Ch3ru09/keyboardA/3d models/HRO  TYPE-C-31-M-12.step

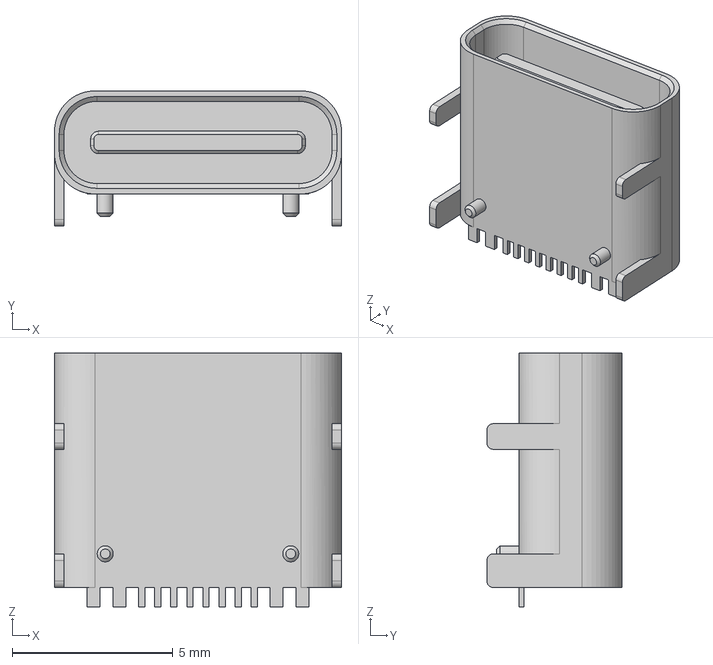
[picture p1: CAD file, 2026-08-06]
3d models/HRO TYPE-C-31-M-12.step
8.94 x 4.21 x 7.90 mm
