Ch3ru09/keyboardA/left/left_base.stl

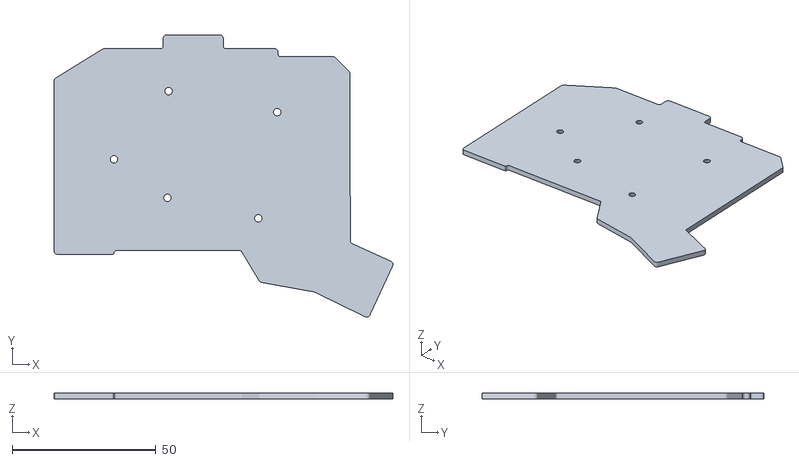
[picture p2: CAD file, 2026-08-14]
left/left_base.stl
118.0 x 98.3 x 2.00
