Ch3ru09/keyboardA/right/right_base.stl

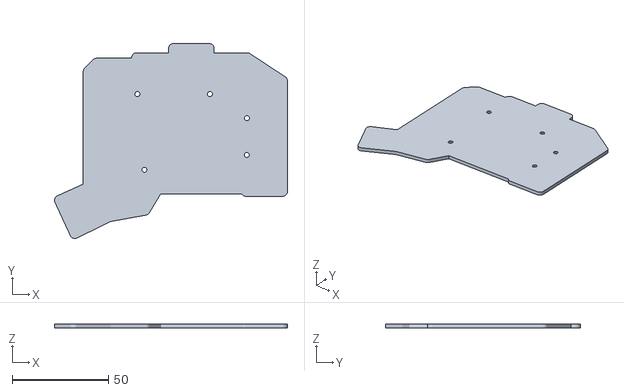
[picture p3: CAD file, 2026-08-14]
right/right_base.stl
120.8 x 101.1 x 2.00
