Ch3ru09/keyboardA/3d models/SW_Kailh_Choc_V1.stp

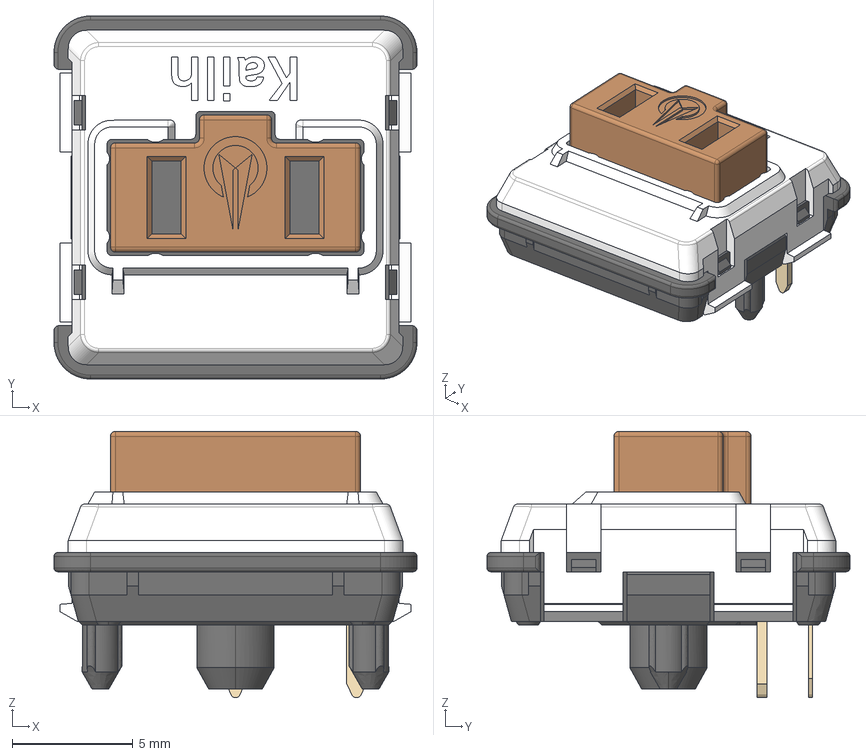
[picture p4: CAD file, 2026-08-06]
3d models/SW_Kailh_Choc_V1.stp
15.0 x 15.0 x 11.0 mm
