Ch3ru09/keyboardA/left/left_cover.stl

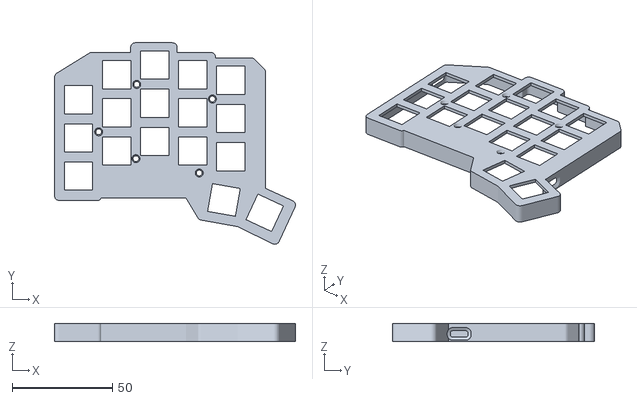
[picture p5: CAD file, 2026-08-14]
left/left_cover.stl
120.4 x 100.7 x 9.00
