Ch3ru09/keyboardA/right/right.step

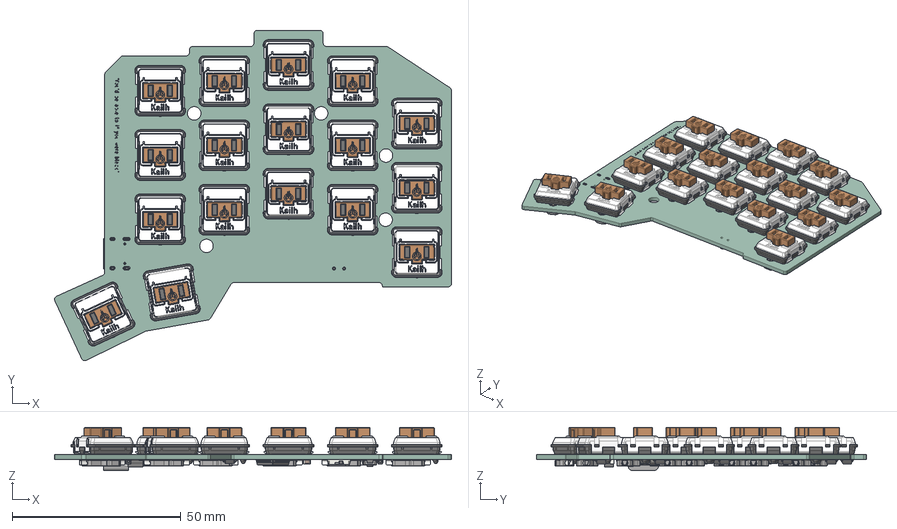
[picture p6: CAD file, 2026-08-14]
right/right.step
117.6 x 97.9 x 12.8 mm
SW_Kailh_Choc_V1_cp x 17
SW_Hotswap_Kailh_Choc_v1 x 17
Fusion_sp
D_SOD-123 x 17
MSOP-10_3x3mm_P0.5mm
LQFP-48_7x7mm_P0.5mm
C_0805_2012Metric x 7
HRO TYPE-C-31-M-12 v4
R_0805_2012Metric x 3
SOT-23-6
D_SMA
Fuse_1206_3216Metric
SOT-23-3
SW_SPST_TS-1088-xR020
right_pad
right_silkscreen x 2
right_PCB
