Ch3ru09/keyboardA/3d models/SW_Hotswap_Kailh_Choc_V1.stp

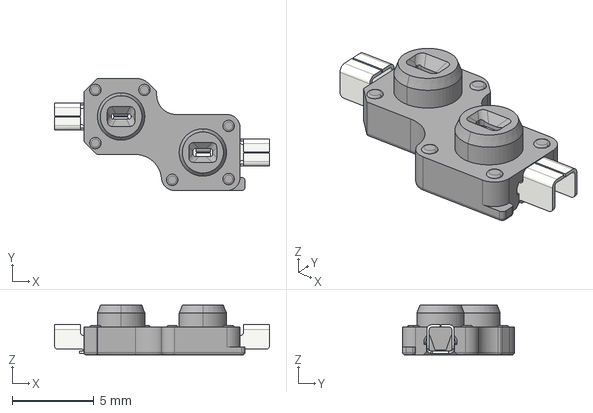
[picture p7: CAD file, 2026-08-06]
3d models/SW_Hotswap_Kailh_Choc_V1.stp
13.2 x 6.85 x 3.05 mm
