Ch3ru09/keyboardA/right/right_cut.step

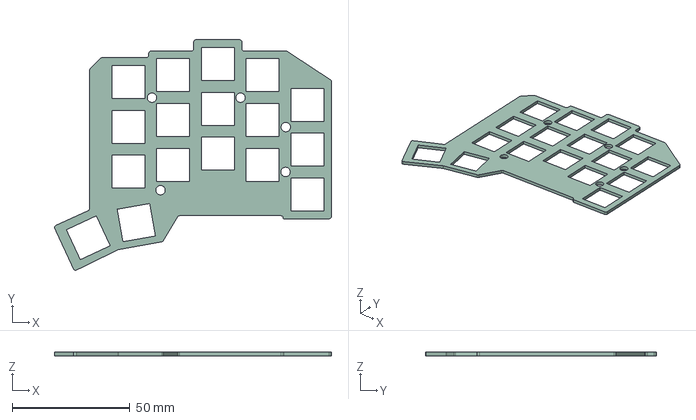
[picture p8: CAD file, 2026-08-14]
right/right_cut.step
117.6 x 97.9 x 1.51 mm
