Ch3ru09/keyboardA/left/left.step

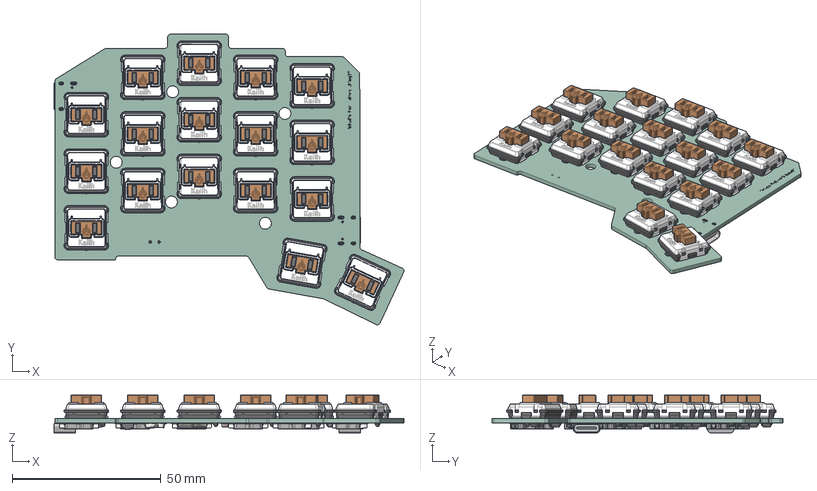
[picture p9: CAD file, 2026-08-06]
left/left.step
117.8 x 97.9 x 12.8 mm
D_SOD-123 x 17
SW_Kailh_Choc_V1_cp x 17
SW_Hotswap_Kailh_Choc_v1 x 17
SOT-23-6 x 2
C_0805_2012Metric x 7
HRO TYPE-C-31-M-12 v4 x 2
Fusion_sp
LQFP-48_7x7mm_P0.5mm
R_0805_2012Metric x 3
SOT-23-3
SW_SPST_TS-1088-xR020
Fuse_1206_3216Metric
left_pad
left_silkscreen x 2
left_PCB
