Ch3ru09/keyboardA/(list of files, cad)

Other CAD files:
right/right_cover.stl
3d models/USB_C_Receptacle_HRO_TYPE-C-31-M-12.step
left/left_cover_print_test.stl
left/left_base_print_test.stl
left/left_cover.f3z
right/right_cover.f3z
