Ch3ru09/keyboardA/right/right.kicad_pcb

## KiCad design right/right.kicad_pcb (2026-08-14)

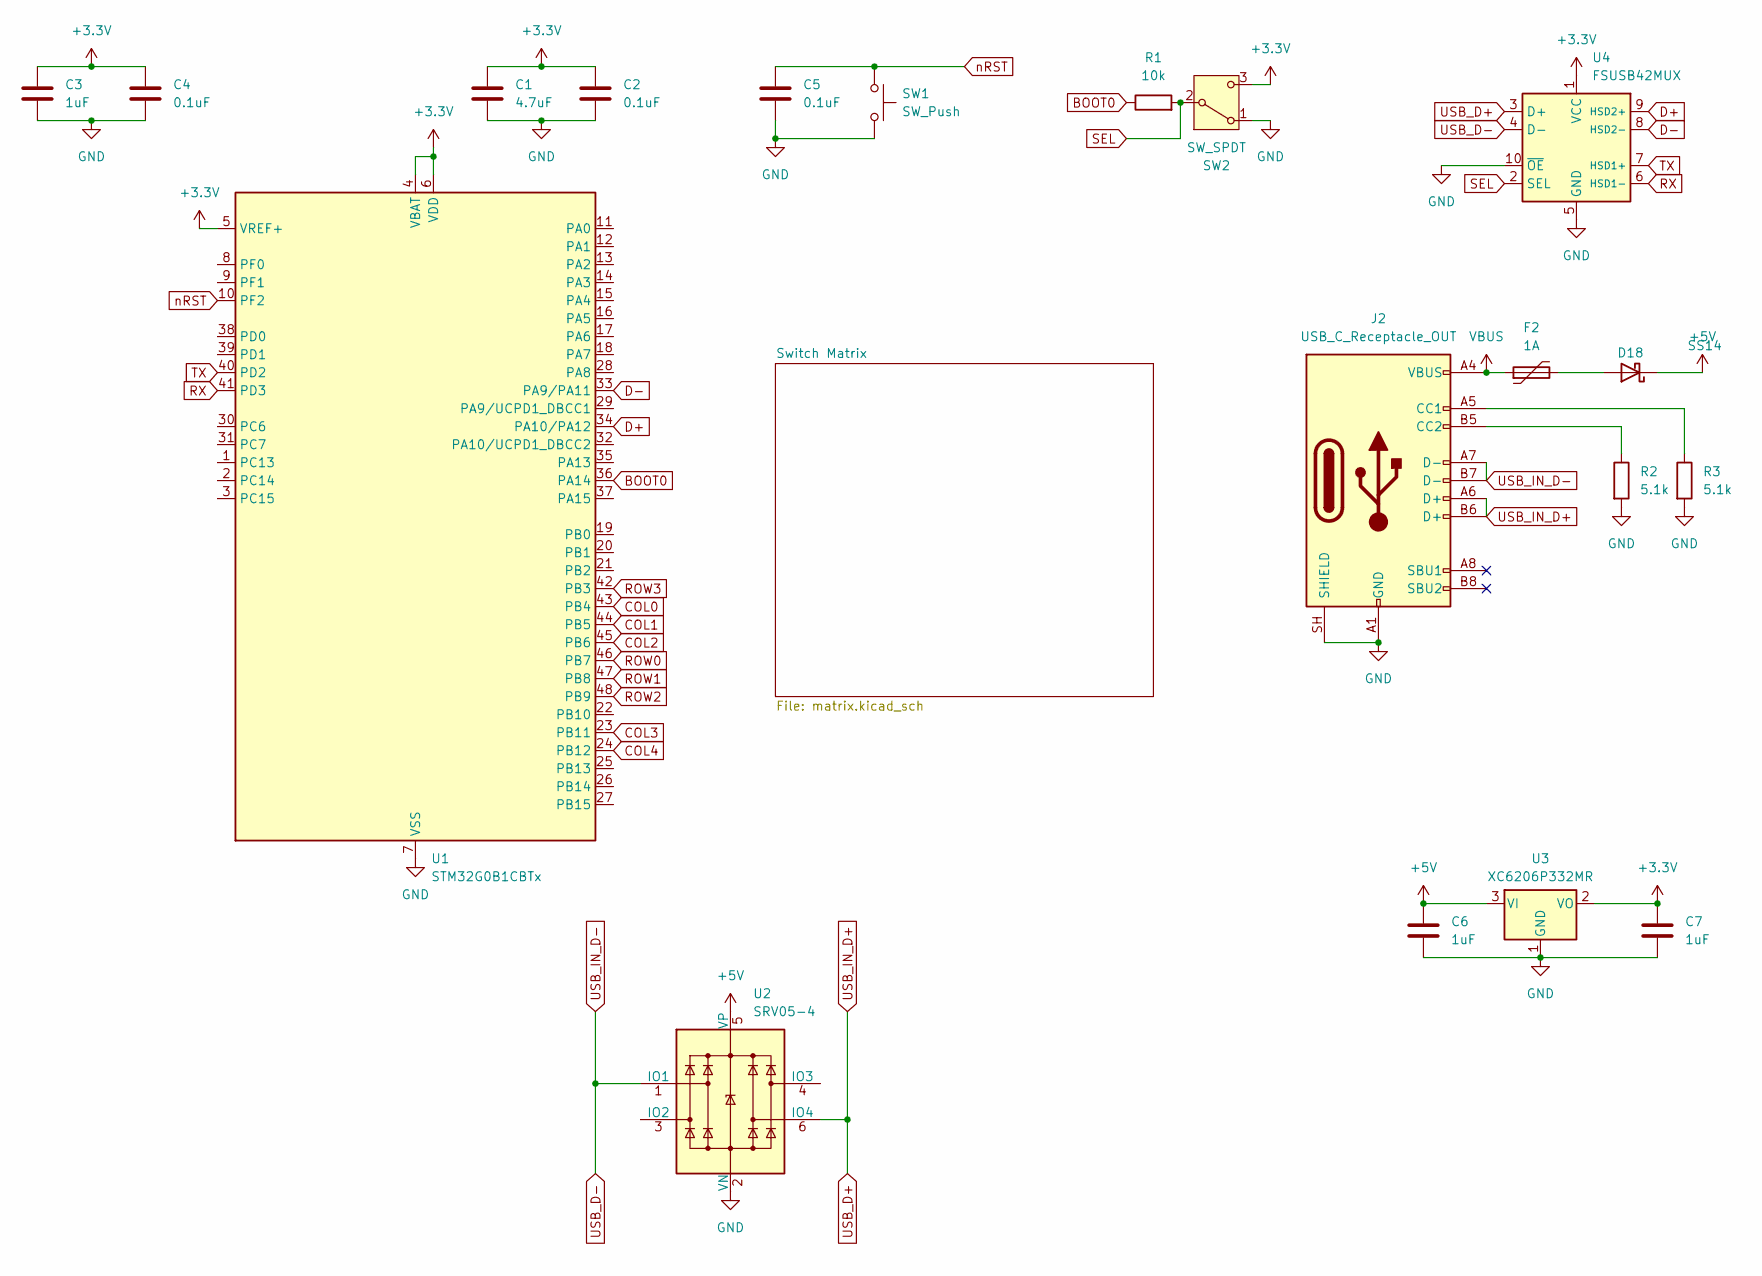
[picture p10: schematic right.kicad_sch]

Parts:
C1: 4.7uF; C_0805_2012Metric_Pad1.18x1.45mm_HandSolder
C2, C4, C5: 0.1uF; C_0805_2012Metric_Pad1.18x1.45mm_HandSolder
C3, C6, C7: 1uF; C_0805_2012Metric_Pad1.18x1.45mm_HandSolder
D18: SS14; D_SMA_Handsoldering
F2: 1A; Fuse_1206_3216Metric
J2: USB_C_Receptacle_OUT; USB_C_Receptacle_HRO_TYPE-C-31-M-12
R1: 10k; R_0805_2012Metric_Pad1.20x1.40mm_HandSolder
R2, R3: 5.1k; R_0805_2012Metric_Pad1.20x1.40mm_HandSolder
SW1: SW_Push; SW_SPST_TS-1088-xR020
SW2: SW_SPDT; SW_SPDT_PCM12
U1: STM32G0B1CBTx; LQFP-48_7x7mm_P0.5mm
U2: SRV05-4; SOT-23-6
U3: XC6206P332MR; SOT-23-3
U4: FSUSB42MUX; MSOP-10_3x3mm_P0.5mm

Connections:
+3.3V: C1.1, C2.1, C3.1, C4.1, C7.1, SW2.3 (C), U1.4 (VBAT), U1.5 (VREF+), U1.6 (VDD), U3.2 (VO), U4.1 (VCC)
+5V: C6.1, D18.1 (K), U2.5 (VP), U3.3 (VI)
BOOT0: R1.1, U1.36 (PA14)
COL0: U1.43 (PB4); also elsewhere on the board
COL1: U1.44 (PB5); also elsewhere on the board
COL2: U1.45 (PB6); also elsewhere on the board
COL3: U1.23 (PB11); also elsewhere on the board
COL4: U1.24 (PB12); also elsewhere on the board
D+: U1.34 (PA10/PA12), U4.9 (HSD2+)
D-: U1.33 (PA9/PA11), U4.8 (HSD2-)
GND: C1.2, C2.2, C3.2, C4.2, C5.2, C6.2, C7.2, J2.A1 (GND), J2.A12 (GND), J2.B1 (GND), J2.B12 (GND), J2.SH (SHIELD), R2.2, R3.2, SW1.2, SW2.1 (A), U1.7 (VSS), U2.2 (VN), U3.1 (GND), U4.5 (GND), U4.10 (~OE)
unnamed: D18.2 (A), F2.2
unnamed: J2.A5 (CC1), R3.1
unnamed: J2.B5 (CC2), R2.1
ROW0: U1.46 (PB7); also elsewhere on the board
ROW1: U1.47 (PB8); also elsewhere on the board
ROW2: U1.48 (PB9); also elsewhere on the board
ROW3: U1.42 (PB3); also elsewhere on the board
RX: U1.41 (PD3), U4.6 (HSD1-)
SEL: R1.2, SW2.2 (B), U4.2 (SEL)
TX: U1.40 (PD2), U4.7 (HSD1+)
USB_D+: J2.A6 (D+), J2.B6 (D+), U2.6 (IO4), U4.3 (D+)
USB_D-: J2.A7 (D-), J2.B7 (D-), U2.1 (IO1), U4.4 (D-)
VBUS: F2.1, J2.A4 (VBUS), J2.A9 (VBUS), J2.B4 (VBUS), J2.B9 (VBUS)
nRST: C5.1, SW1.1, U1.10 (PF2)

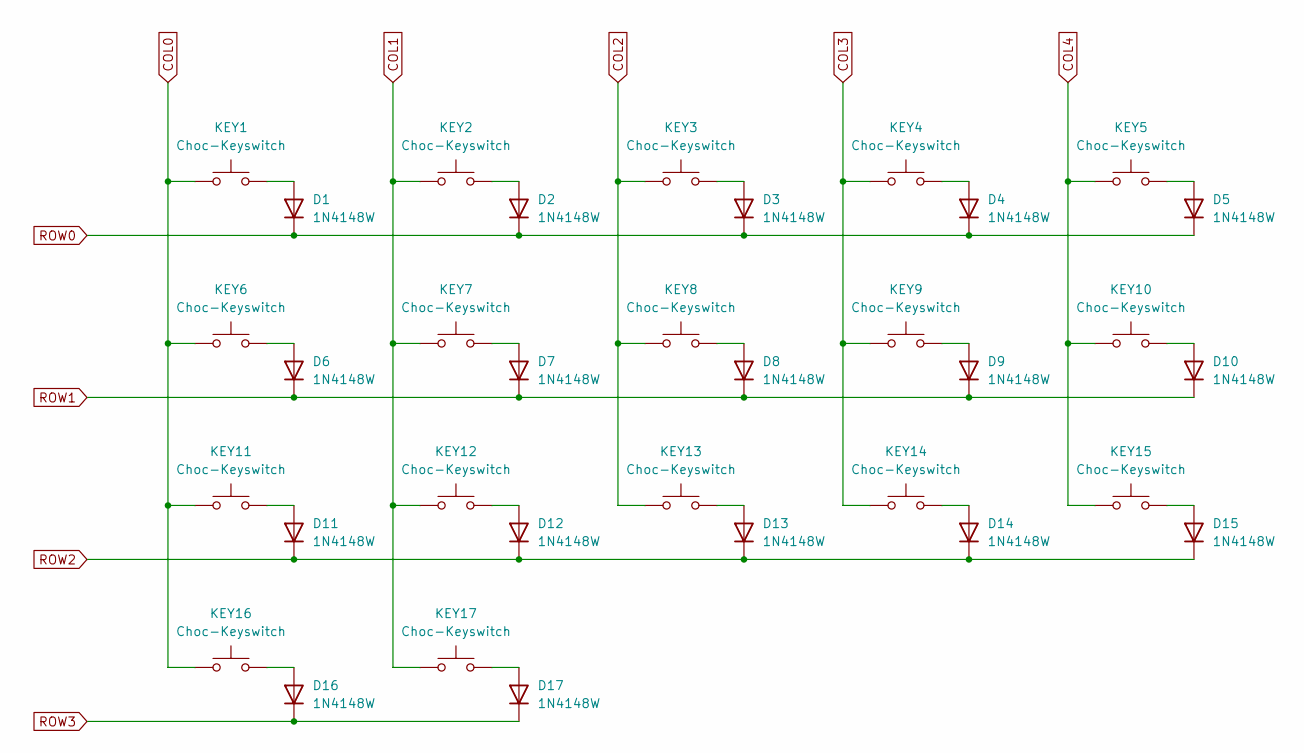
[picture p11: schematic matrix.kicad_sch]

Parts:
D1, D2, D3, D4, D5, D6, D7, D8, D9, D10, D11, D12, D13, D14, D15, D16, D17: 1N4148W; D_SOD-123
KEY1, KEY2, KEY3, KEY4, KEY5, KEY6, KEY7, KEY8, KEY9, KEY10, KEY11, KEY12, KEY13, KEY14, KEY15, KEY16, KEY17: Choc-Keyswitch; SW_choc_v1_HS_CPG135001S30_1u

Connections:
COL0: KEY1.1, KEY6.1, KEY11.1, KEY16.1; also elsewhere on the board
COL1: KEY2.1, KEY7.1, KEY12.1, KEY17.1; also elsewhere on the board
COL2: KEY3.1, KEY8.1, KEY13.1; also elsewhere on the board
COL3: KEY4.1, KEY9.1, KEY14.1; also elsewhere on the board
COL4: KEY5.1, KEY10.1, KEY15.1; also elsewhere on the board
unnamed: D1.2 (A), KEY1.2
unnamed: D2.2 (A), KEY2.2
unnamed: D3.2 (A), KEY3.2
unnamed: D4.2 (A), KEY4.2
unnamed: D5.2 (A), KEY5.2
unnamed: D6.2 (A), KEY6.2
unnamed: D7.2 (A), KEY7.2
unnamed: D8.2 (A), KEY8.2
unnamed: D9.2 (A), KEY9.2
unnamed: D10.2 (A), KEY10.2
unnamed: D11.2 (A), KEY11.2
unnamed: D12.2 (A), KEY12.2
unnamed: D13.2 (A), KEY13.2
unnamed: D14.2 (A), KEY14.2
unnamed: D15.2 (A), KEY15.2
unnamed: D16.2 (A), KEY16.2
unnamed: D17.2 (A), KEY17.2
ROW0: D1.1 (K), D2.1 (K), D3.1 (K), D4.1 (K), D5.1 (K); also elsewhere on the board
ROW1: D6.1 (K), D7.1 (K), D8.1 (K), D9.1 (K), D10.1 (K); also elsewhere on the board
ROW2: D11.1 (K), D12.1 (K), D13.1 (K), D14.1 (K), D15.1 (K); also elsewhere on the board
ROW3: D16.1 (K), D17.1 (K); also elsewhere on the board

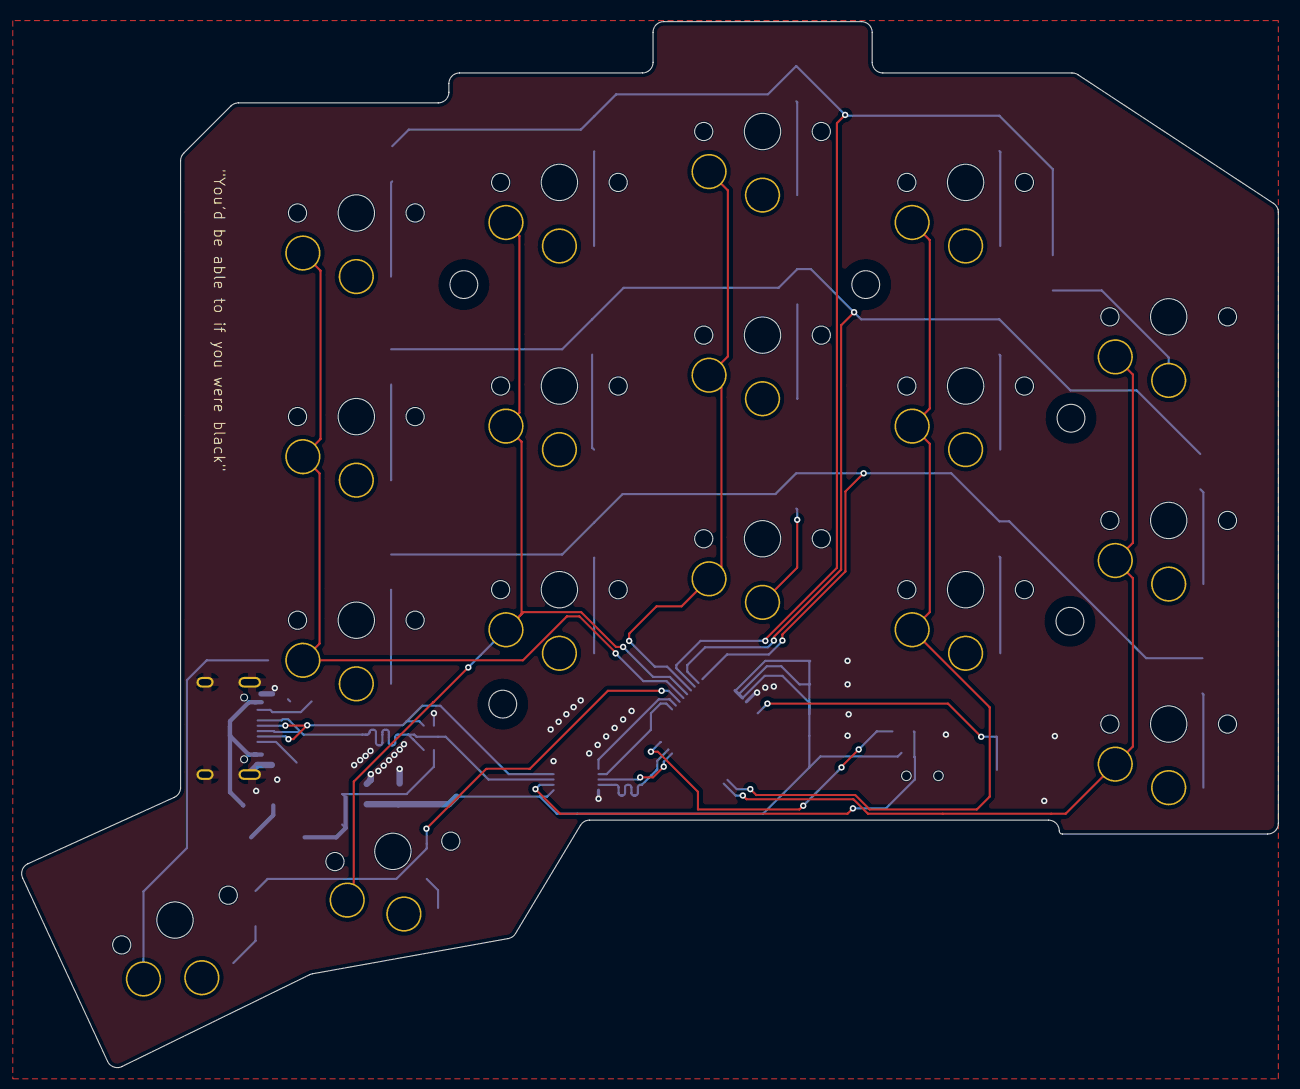
[picture p12: board right.kicad_pcb from above]

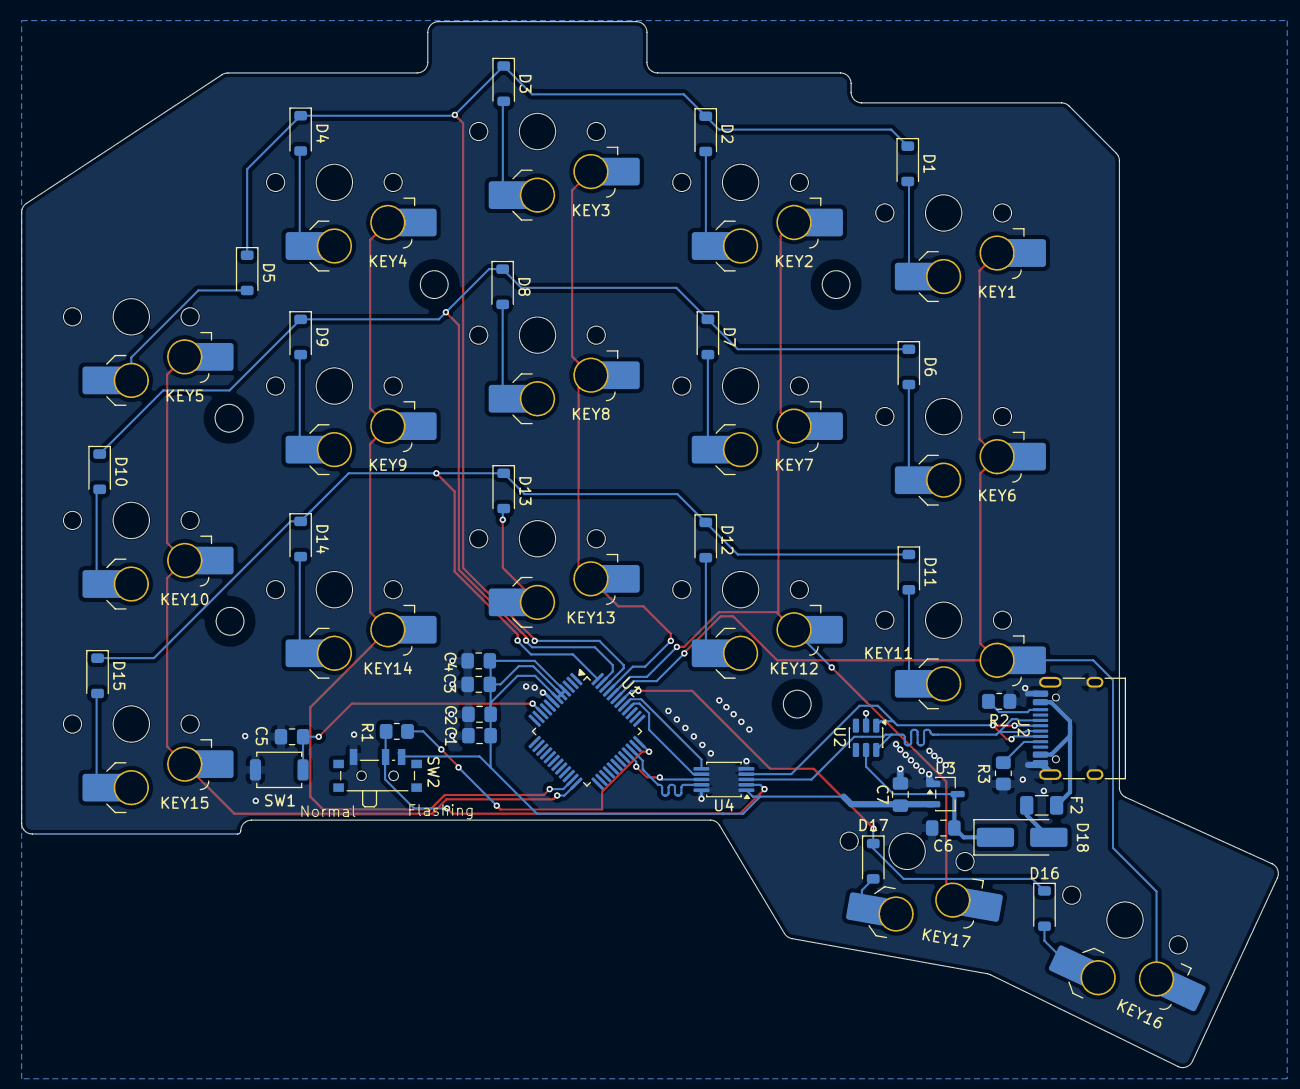
[picture p13: board right.kicad_pcb from below]

Board: 2 copper layers, 117.6 x 97.9 mm, 53 parts (53 on the bottom side), 42 nets.
