Ch3ru09/keyboardA/(commit log)

2026-05-25 creted most of the schematic
    [keyboardA.kicad_sch, matrix.kicad_sch]
2026-05-26 added a keyswitch submodule
    [keyboardA.kicad_sch, matrix.kicad_sch]
2026-05-26 finished assigning footprints
    [keyboardA.kicad_sch, matrix.kicad_sch]
2026-05-27 thought i was done with pcb but forgot to add a second usb port
    [keyboardA.kicad_pcb, keyboardA.kicad_sch]
2026-05-27 moved current files to left
    [left.kicad_pcb, left.kicad_sch, matrix.kicad_sch]
2026-05-28 redesigned pcb
    [left.kicad_pcb, left.kicad_sch, matrix.kicad_sch]
2026-05-28 should be done?
    [left.kicad_pcb, left.kicad_sch]
2026-05-28 removed warnings
    [left.kicad_pcb, matrix.kicad_sch]
2026-05-28 added right
    [right.kicad_pcb, right.kicad_sch]
2026-05-28 done right side
    [matrix.kicad_sch, right.kicad_pcb, right.kicad_sch]
2026-05-29 unverified done right
    [matrix.kicad_sch, right.kicad_pcb]
2026-05-29 unverified left
    [left.kicad_pcb]
2026-05-29 fixed schematics
    [left.kicad_pcb, left.kicad_sch, matrix.kicad_sch, right.kicad_pcb, right.kicad_sch]
2026-05-30 i dunno what i added
    [left.kicad_pcb]
2026-05-31 v3 for the right side
    [left.kicad_sch, matrix.kicad_sch, right.kicad_pcb, right.kicad_sch]
2026-06-01 v3 for left
    [left.kicad_pcb, left.kicad_sch, matrix.kicad_sch]
2026-06-01 length matched d+ and d- on left
    [left.kicad_pcb]
2026-06-01 generated bill of material
    [left.csv, right.csv]
2026-06-01 fixed rx tx
    [right.kicad_pcb, right.kicad_sch]
2026-06-01 changed data protection lines from 3.3v to 5v
    [left.kicad_pcb, left.kicad_sch]
2026-06-01 updated bom
    [left.kicad_pcb]
2026-06-03 sent to jcl for production
    [KeyboardA-left_bom.csv, KeyboardA-left_designators.csv, KeyboardA-left_positions.csv, KeyboardA-right_bom.csv, KeyboardA-right_designators.csv, KeyboardA-right_positions.csv, left.kicad_pcb, left.kicad_sch]
2026-08-02 created .step file
    [left.step]
2026-08-02 trying to create case for the left side
    [case_left.FCStd, left-Edge_Cuts.dxf, left.step]
2026-08-03 created base plate
    [case_left.FCStd, left_base.kicad_pcb, left_base.step]
2026-08-03 added stl file
    [left_base.stl]
2026-08-04 added cover
    [left_base.kicad_pcb, left_cover.kicad_pcb, left_cover.stl]
2026-08-04 removed stl files and added step files
    [left-Edge_Cuts.dxf, left_base.stl, left_cover.step, left_cover.stl]
2026-08-04 modified edge cut
    [left_cover.kicad_pcb, left_cover.step]
2026-08-05 gotta reprint the board because of misplaced usb
    [case_left.FCStd, left.csv, left.step, left_base.kicad_pcb, left_base.step, left_cover.kicad_pcb, left_cover.step]
2026-08-05 needed to move the usbs on left side
    [left.kicad_pcb]
2026-08-05 added vias to left to connect the zones a bit better
    [left.kicad_pcb]
2026-08-06 finished modifying right side
    [KeyboardA-right_bom.csv, KeyboardA-right_designators.csv, KeyboardA-right_positions.csv, right.csv, right.kicad_pcb, right.step]
2026-08-06 added a few 3d files
    [HRO TYPE-C-31-M-12.step, SW_Hotswap_Kailh_Choc_V1.stp, SW_Kailh_Choc_V1.stp, USB_C_Receptacle_HRO_TYPE-C-31-M-12.step, left.kicad_pcb, left.step]
2026-08-06 compiled new files for production
    [left.kicad_pcb, left.step, right.kicad_pcb, right.step]
2026-08-06 added new production files for left side
    [KeyboardA-left_bom.csv, KeyboardA-left_designators.csv, KeyboardA-left_positions.csv, left.kicad_pcb, left.step]
2026-08-06 pushed usb a bit outwards for better fitting with the case
    [left.kicad_pcb, left.step, right.kicad_pcb, right.step]
2026-08-13 removed a hole on right and exported step file
    [right.kicad_pcb, right.step]
2026-08-13 updated right
    [right.kicad_pcb]
2026-08-14 added latest printing files
    [left_base_print_test.stl, left_cover_print_test.stl]
2026-08-14 current status of the covers
    to see the older versions, see email
    [left_cover.f3z, right_cover.f3z]
2026-08-14 added cut for the right side
    [right_cut.kicad_pcb, right_cut.kicad_sch, right_cut.step]
2026-08-14 moved right_cut
    [right_cut.kicad_pcb, right_cut.kicad_sch, right_cut.step]
2026-08-14 added 3d models and moved the usb port a bit on right
    [right.kicad_pcb, right.step]
2026-08-14 new step file
    [right.step]
2026-08-14 tweaked right usb a lot, hopefully this is it; waiting for screws
    [left_cover.f3z, right.kicad_pcb, right.step, right_cover.f3z]
2026-08-14 created stl files for 3d printing
    [left_base.stl, left_cover.stl, right_base.stl, right_cover.stl]
2026-08-14 saved files
    [left_cover.f3z, right_cover.f3z]
2026-08-14 changed screws to m2.5
    [left_base.stl, left_cover.f3z, left_cover.stl, right_base.stl, right_cover.f3z, right_cover.stl]
2026-08-14 merged the files
    [left.kicad_pcb, right.kicad_pcb]
2026-08-17 updated fusion files
    [left_cover.f3z, right_cover.f3z]
